GhazaliNizaam/SAP-1-Architecture-based-8-bit-Computer-Design-and-Implementation/README.md

# SAP-1-Architecture-based-8-bit-Computer-Design-and-Implementation
