GhazaliNizaam/SAP-1-Architecture-based-8-bit-Computer-Design-and-Implementation/(list of files, drawings)

Other design files:
clock timer.pdsprj
Custom Ram Sap.pdsprj
SAP 1 PROJECT 4308 (With Negative Number).pdsprj
